illusion8064/audio-amplifier/hardware/assembled-circuit/filter.png

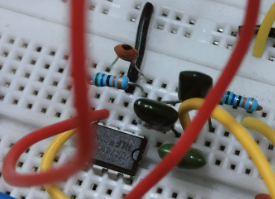
hardware/assembled-circuit/filter.png
