illusion8064/audio-amplifier/hardware/assembled-circuit/pre-amp.png

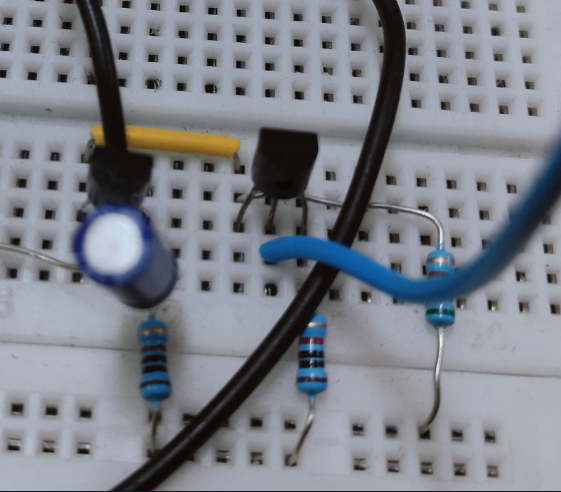
hardware/assembled-circuit/pre-amp.png
