illusion8064/audio-amplifier/hardware/oscilloscope-outputs/filter.png

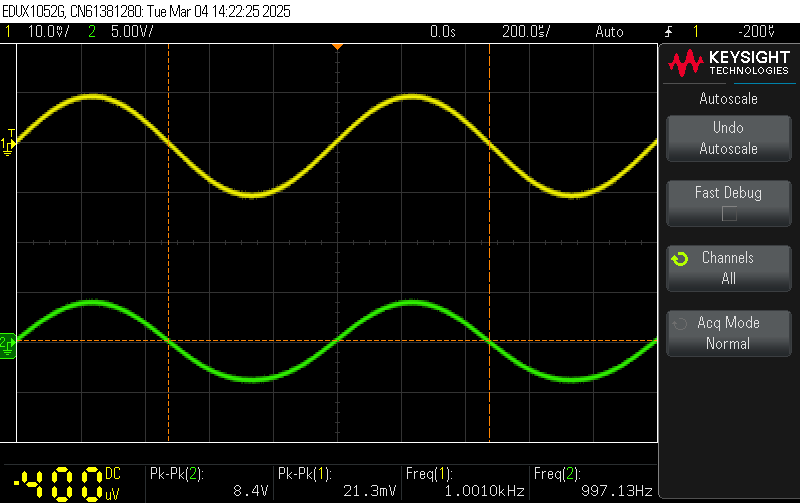
hardware/oscilloscope-outputs/filter.png
