illusion8064/audio-amplifier/hardware/oscilloscope-outputs/fra-lower.png

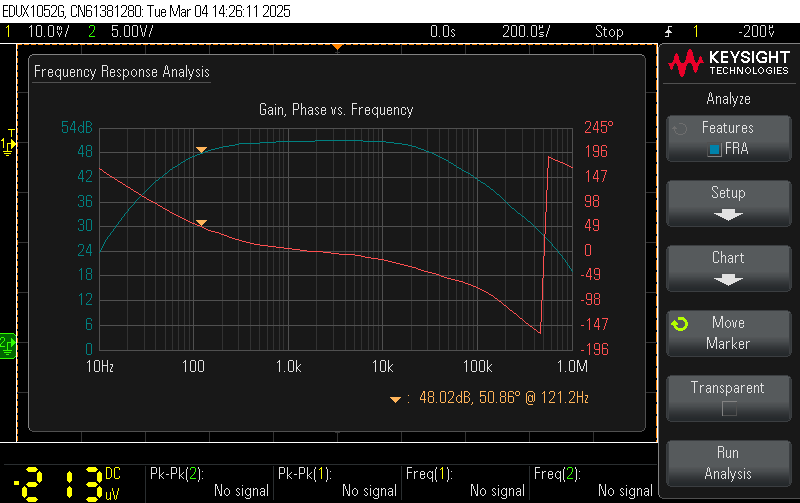
hardware/oscilloscope-outputs/fra-lower.png
