illusion8064/audio-amplifier/hardware/oscilloscope-outputs/gain-stage.png

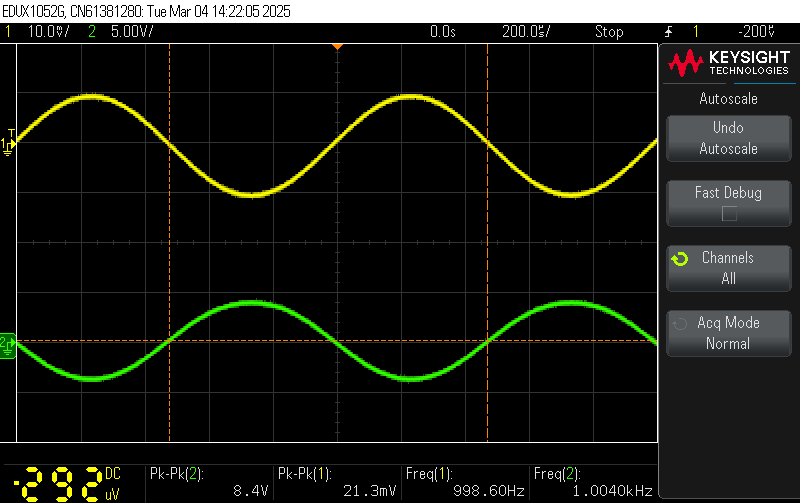
hardware/oscilloscope-outputs/gain-stage.png
