illusion8064/audio-amplifier/hardware/bill-of-materials.md

## bill of materials

| ref | mfg | part no | description |
|---|---|---|---|
| c1 | -- | -- | capacitor, 2μf |
| c2 | -- | -- | capacitor, 2μf |
| c3 | -- | -- | capacitor, 16nf |
| c4 | -- | -- | capacitor, 16pf |
| c5 | -- | -- | capacitor, 10μf |
| ce1 | -- | -- | capacitor, 10μf |
| d2 | onsemi | 1n4148 | diode |
| d3 | onsemi | 1n4148 | diode |
| q1 | nxp | bc547b | bipolar transistor |
| q2 | nxp | bc547b | bipolar transistor |
| q3 | nxp | bc547b | bipolar transistor |
| q4 | -- | tip32c | bipolar transistor |
| q5 | -- | tip31c | bipolar transistor |
| r1 | -- | -- | resistor, 500k |
| r2 | -- | -- | resistor, 500k |
| r3 | -- | -- | resistor, 1k |
| r4 | -- | -- | resistor, 1k |
| rb1 | -- | -- | resistor, 80k |
| rb2 | -- | -- | resistor, 9.5k |
| rc1 | -- | -- | resistor, 5.2k |
| rc2 | -- | -- | resistor, 5.2k |
| re | -- | -- | resistor, 5k |
| re1 | -- | -- | resistor, 800 |
| rl | -- | -- | resistor, 8k |
| rl2 | -- | -- | resistor, 10 |
| u1 | (unknown)| ua741 | (unknown 3rd party model) |
