illusion8064/audio-amplifier/simulations/spice-files/filter.asc

C1: cap; 16n
C2: cap; 16p
R1: res; 500k
R2: res; 500k
U1: opamp2; UA741
V1: voltage; SINE(0 4 1k)
VCC1: voltage; 12
VEE1: voltage; -12
Named nets: 0, Vout
;ac dec 500 1 1meg
.include UA741.301
.tran 1m
