illusion8064/audio-amplifier/simulations/spice-files/full-circuit.asc

C1: cap; 2µ
C2: cap; 2µ
C3: cap; 16n
C4: cap; 16p
C5: cap; 10µ
C6: cap; 10µ
CE1: cap; 1n
D2: diode; 1N4148
D3: diode; 1N4148
Q1: npn; BC547B
Q2: npn; BC547B
Q3: npn; BC547B
Q4: npn; TIP32C
Q5: pnp; TIP31C
R1: res; 500k
R2: res; 500k
R3: res; 1k
R4: res; 1k
Rb1: res; 80k
Rb2: res; 9.5k
RC1: res; 5.2k
RC2: res; 5.2k
RE1: res; 800
RE: res; 5k
RL2: res; 10
RL: res; 8k
U1: opamp2; UA741
V1: voltage; 5
V2: voltage; -5
V3: voltage; -6
VCC1: voltage; 12
VCC2: voltage; 6
VCC: voltage; 5
VEE1: voltage; -12
VEE: voltage; -5
Vin1: voltage; SINE(0 20m 1k); AC 1
Named nets: 0, Vout, Vin, vout
.tran 3m
;ac dec 500 1 1meg
.include UA741.301
.include TIP32C.LIB
.include TIP31C.LIB
