illusion8064/audio-amplifier/simulations/spice-files/gain-stage.asc

C1: cap; 2µ
C2: cap; 2µ
CE1: cap; 1n
Q1: npn; BC547B
Rb1: res; 91k
Rb2: res; 10k
RE1: res; 800
RL1: res; 8k
V1: voltage; 5
V2: voltage; -5
V3: voltage; SINE(0 400m 1k)
Named nets: 0, vout
.tran 1m
