illusion8064/audio-amplifier/simulations/spice-files/power-amp.asc

C1: cap; 10µ
C2: cap; 10µ
D1: diode; 1N4148
D2: diode; 1N4148
Q1: npn; TIP32C
Q2: pnp; TIP31C
R1: res; 1.5k
R2: res; 1.5k
RL1: res; 10
V1: voltage; -8
V2: voltage; SINE(0 4.5 1k 0 0)
VCC1: voltage; 8
Named nets: 0, vout
.include TIP32C.LIB
.include TIP31C.LIB
.tran 1m
