illusion8064/audio-amplifier/simulations/spice-files/pre-amp.asc

Q1: npn; BC547B
Q2: npn; BC547B
RC1: res; 5.2k
RC2: res; 5.2k
RE1: res; 5k
VCC1: voltage; 5
VEE1: voltage; -5
Vin1: voltage; SINE(0 20m 1k); AC 1
Named nets: 0, vout
.tran 1m
