illusion8064/audio-amplifier/hardware/assembled-circuit/full-circuit.png

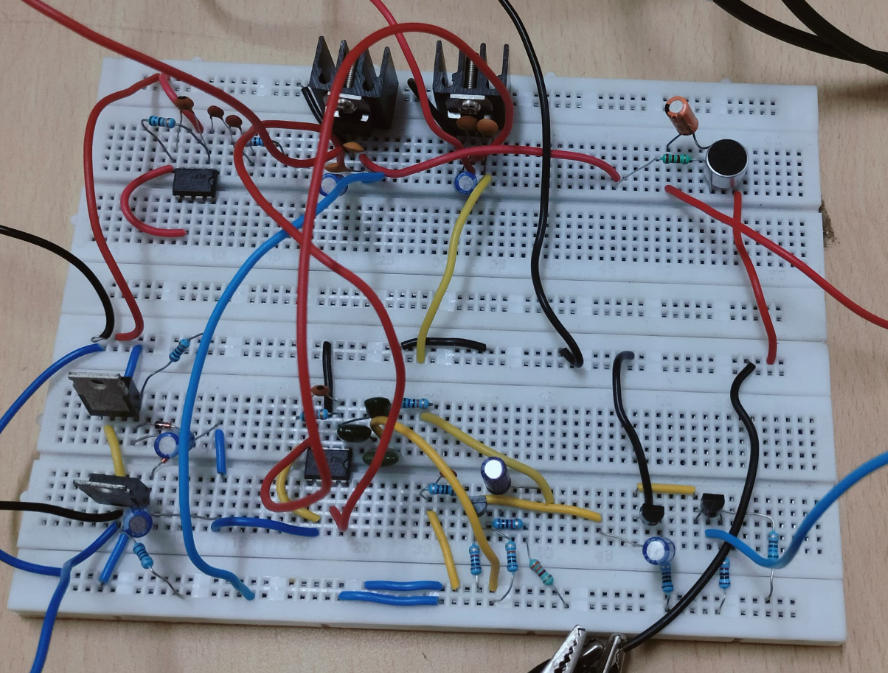
hardware/assembled-circuit/full-circuit.png
