illusion8064/audio-amplifier/hardware/assembled-circuit/gain-stage.png

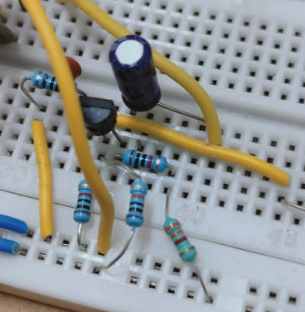
hardware/assembled-circuit/gain-stage.png
