illusion8064/audio-amplifier/hardware/assembled-circuit/mic.png

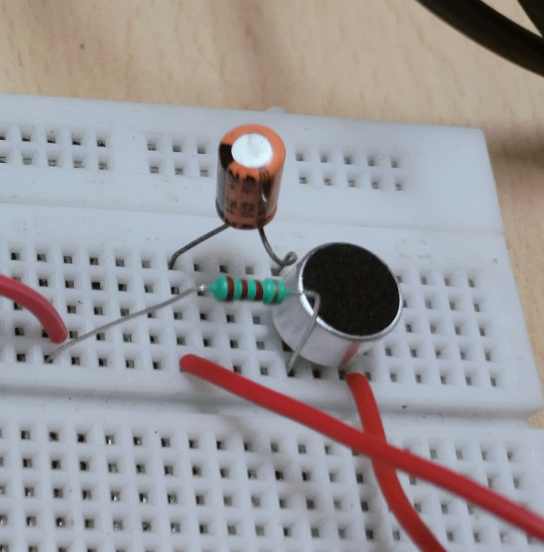
hardware/assembled-circuit/mic.png
