illusion8064/audio-amplifier/hardware/assembled-circuit/power-amp.png

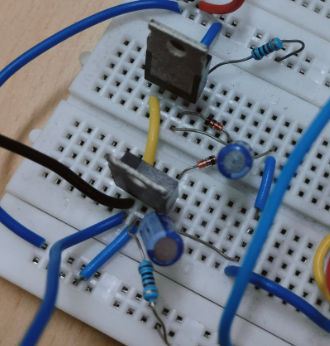
hardware/assembled-circuit/power-amp.png
