illusion8064/audio-amplifier/hardware/assembled-circuit/voltage-divider.png

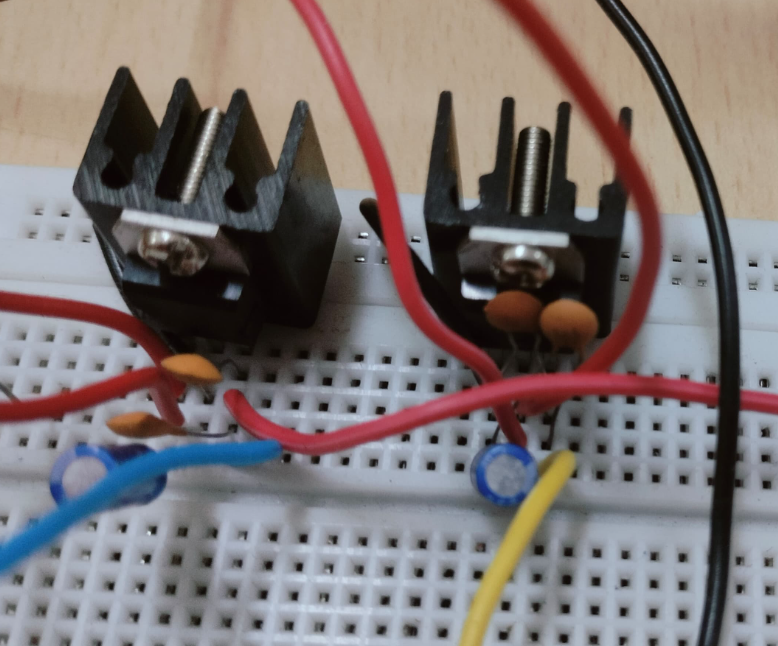
hardware/assembled-circuit/voltage-divider.png
